khaare/Final-year/CAD Files/Assembly4.stp

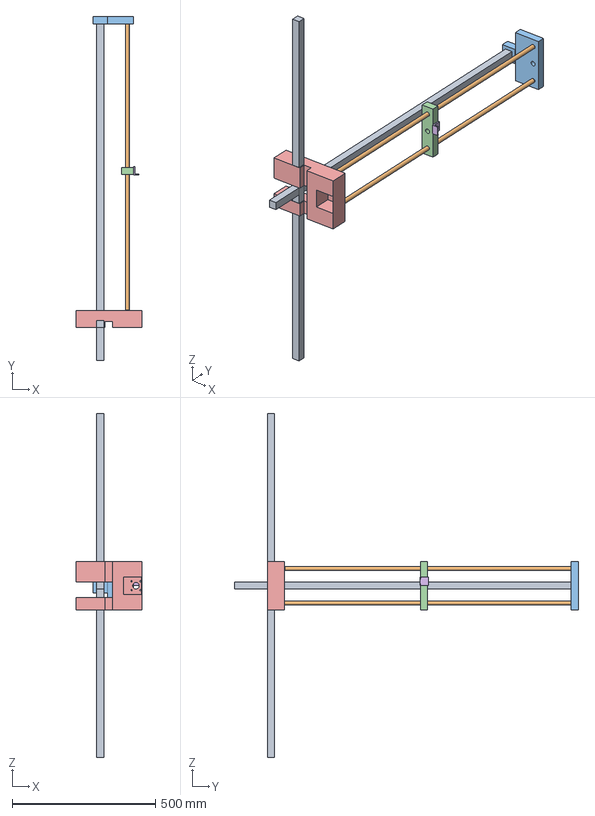
[picture p1: CAD file, 2026-11-03]
CAD Files/Assembly4.stp
230.0 x 1200.0 x 1200.0 mm
neck x 2
guard_rail x 2
top_holder
bearing_housing
Base
barHoldeript
