khaare/Final-year/(list of files, cad)

Other CAD files:
CAD Files/Assembly4.iam
CAD Files/Base.ipt
CAD Files/NutHousing.ipt
CAD Files/barHoldeript.ipt
CAD Files/bearing_housing.ipt
CAD Files/bracket.ipt
CAD Files/motor_hider_housing.ipt
CAD Files/top_holder.ipt
CAD Files/top_rod.ipt
