khaare/Final-year/CAD Files/Assembly4_final_v5.png

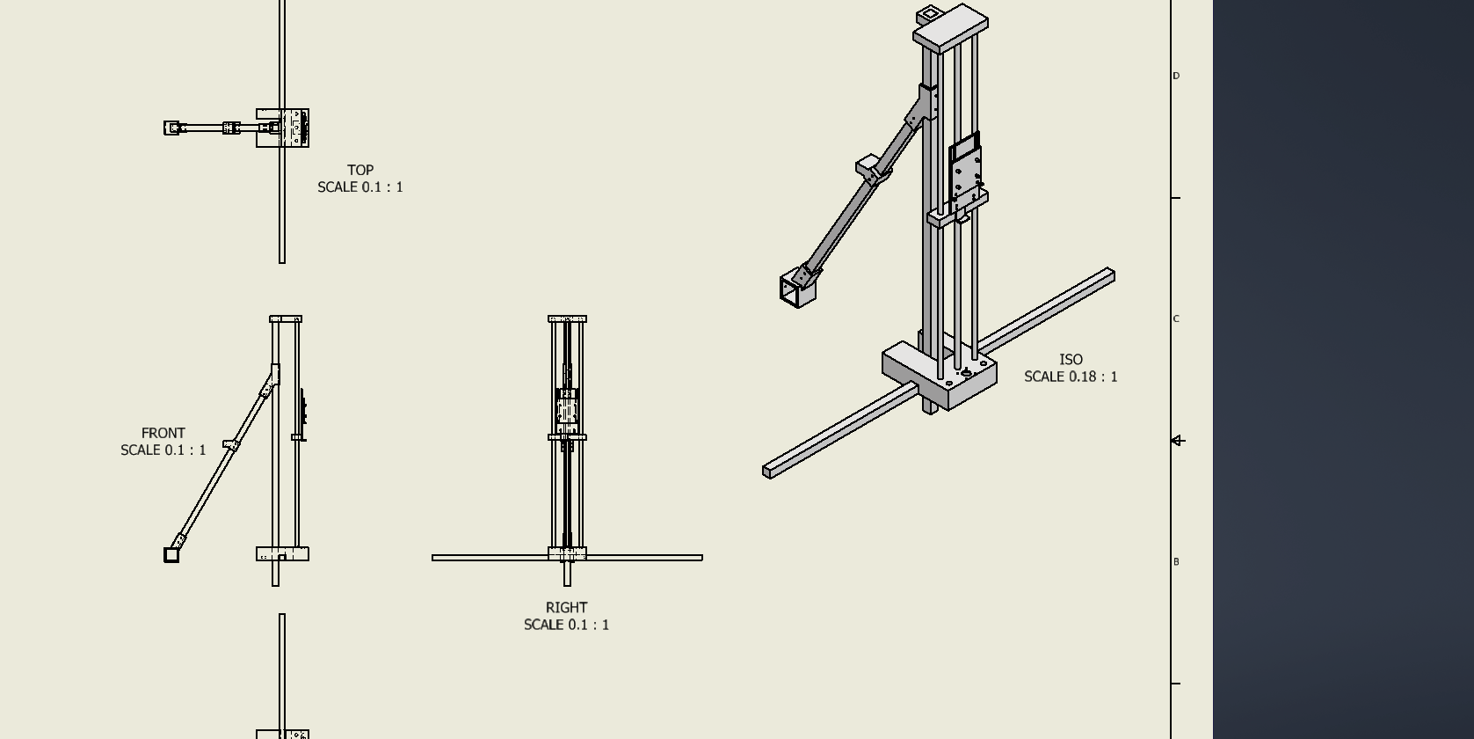
CAD Files/Assembly4_final_v5.png
