khaare/Final-year/(commit log)

2026-11-03 Create CAD Files
2026-11-03 DESIGN FILES
    [Assembly4.iam, Assembly4.stp, Base.ipt, NutHousing.ipt, barHoldeript.ipt, bearing_housing.ipt, bracket.ipt, motor_hider_housing.ipt]
